CircuitCo/BeagleBone-LCD7-RevA1/(list of files, drawings)

Other design files:
BeagleBone-LCD7-RevA1-schematic.dsn
