CircuitCo/BeagleBone-LCD7-RevA1/(commit log)

2012-04-27 first add
    [BeagleBone-LCD7-RevA1-bom.xls, BeagleBone-LCD7-RevA1-schematic.dsn]
2012-05-03 add LCD part number
    [BeagleBone-LCD7-RevA1-bom.xls, BeagleBone-LCD7-RevA1A-bom.xls]
2012-10-03 rm bom a1a
    [BeagleBone-LCD7-RevA1A-bom.xls]
2012-10-03 upd bom a1
    [BeagleBone-LCD7-RevA1A-bom.xls]
